SensaGroup/MotorDriver/Hardware/Docs/Output/MotorDriver.pdf

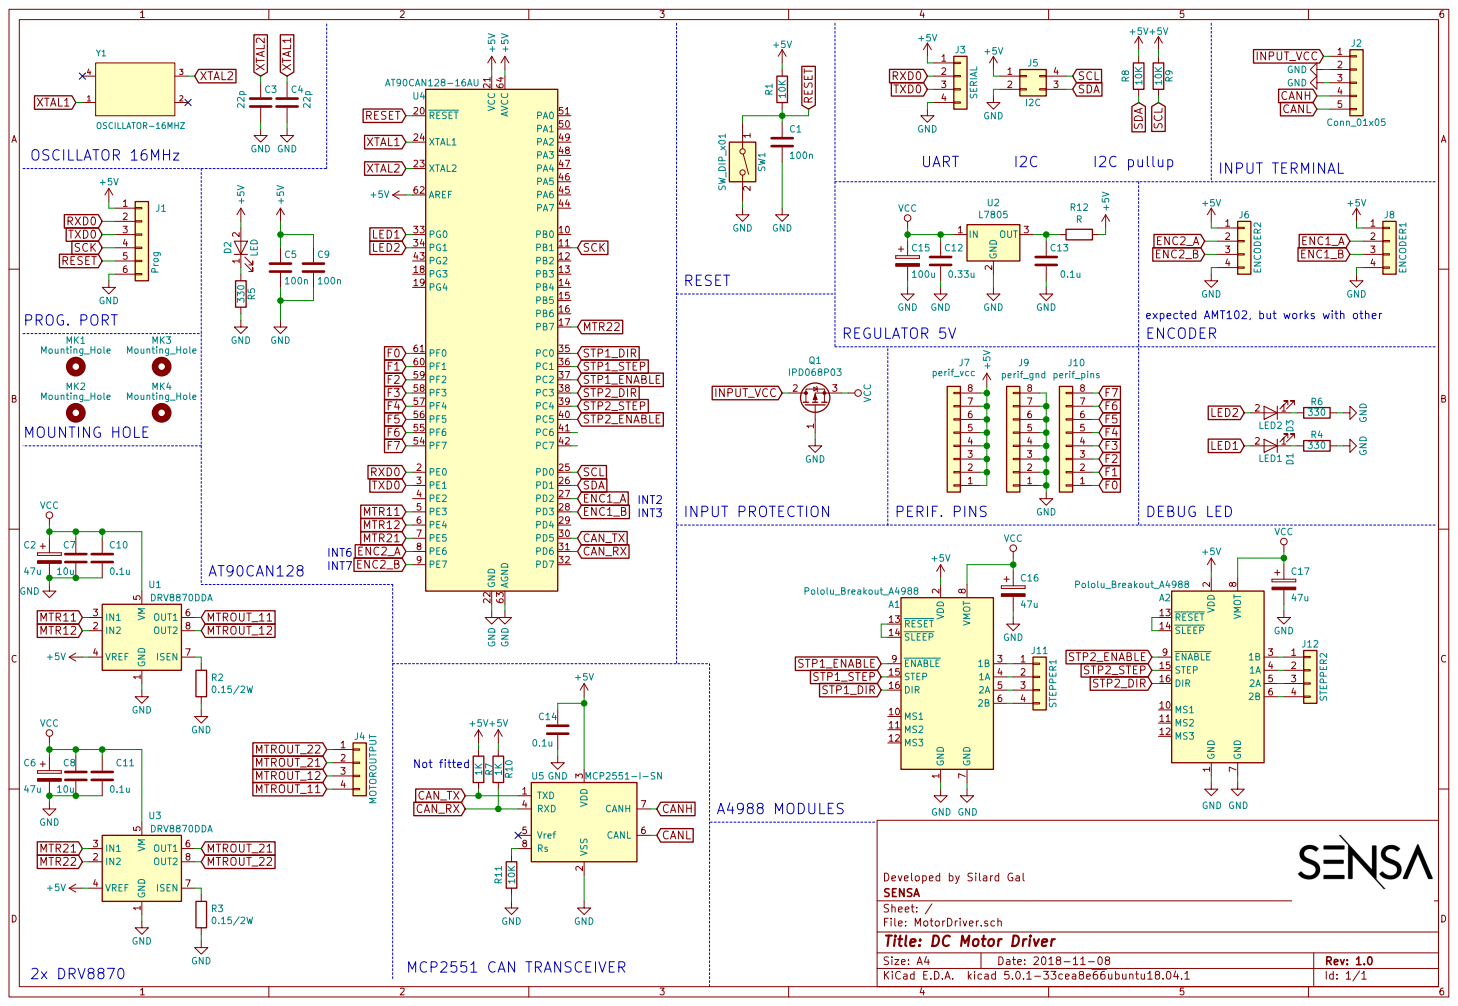
[picture p2: page 1]

1 2 D2 LED 330 R5 GND+5V MK1 Mounting_Hole MK3 Mounting_Hole MK2 Mounting_Hole MK4 Mounting_Hole GND GND CANL

expected AMT102, but works with other

1 MS1 10 MS2 11 MS3 12 RESET 13 SLEEP 14 STEP 15 DIR 16 VDD

3 RXD 4 Vref 5 CANL 6 CANH 7 Rs 8 R10 U5 MCP2551-I-SN 1KR7 1KNot fitted

Developed by Silard Gal
Id: 1/1 Title: DC Motor Driver File: MotorDriver.sch Sheet: / SENSA
