SensaGroup/MotorDriver/Hardware/MotorDriver.kicad_pcb

## KiCad design Hardware/MotorDriver.kicad_pcb (2018-11-23)

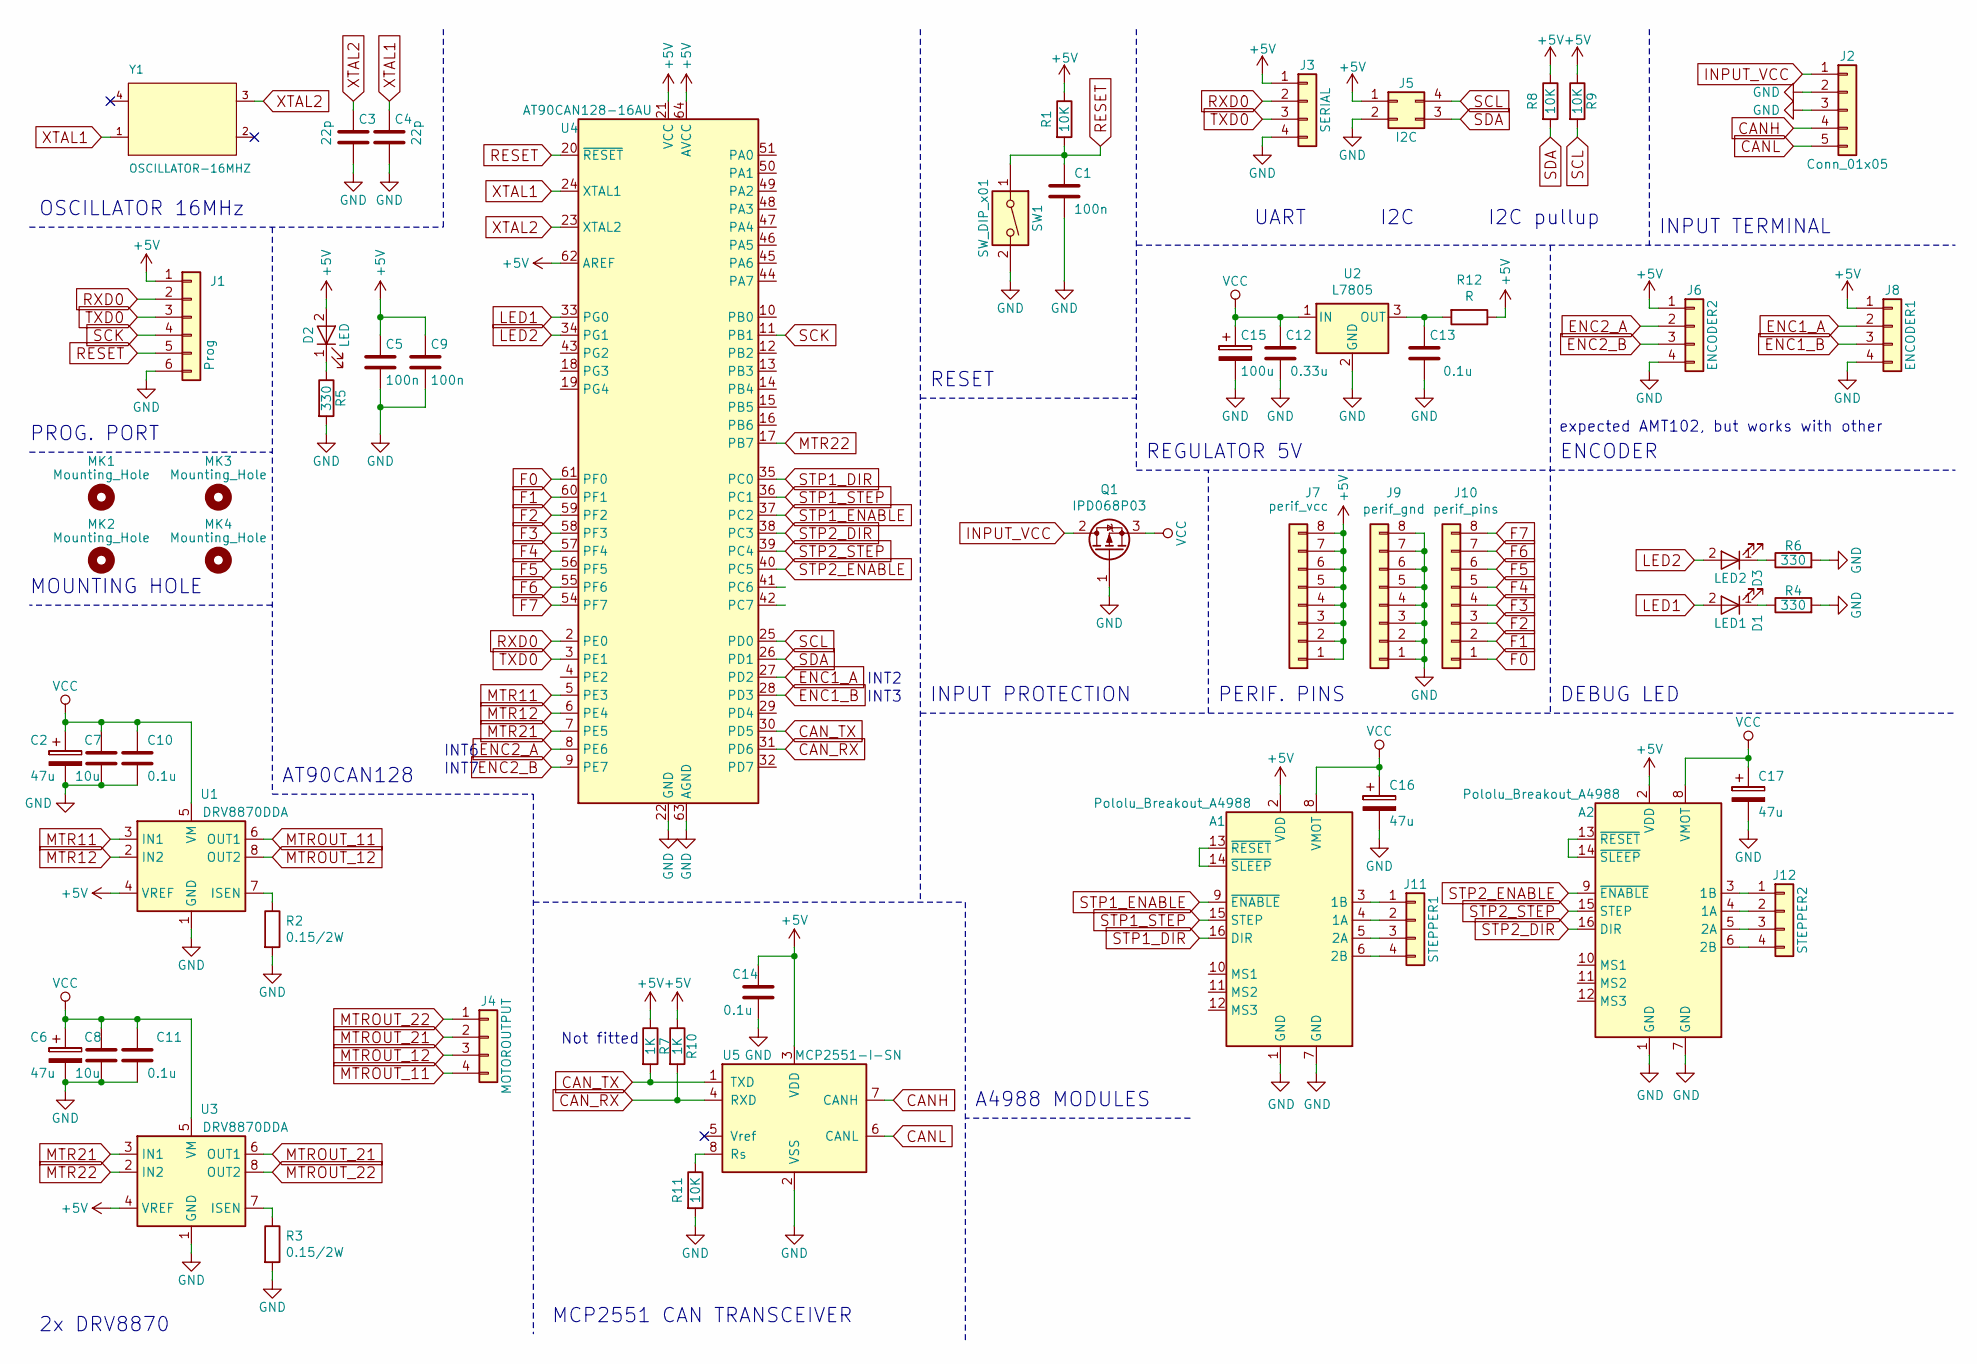
[picture p3: schematic MotorDriver.sch, DC Motor Driver]

Parts:
A1, A2: Pololu_Breakout_A4988; Pololu_Breakout-16_15.2x20.3mm
C1, C5, C9: 100n; C_0603_1608Metric
C2, C6, C16, C17: 47u; CP_Elec_6.3x5.4
C3, C4: 22p; C_0603_1608Metric
C7, C8: 10u; C_0805_2012Metric
C10, C11, C13, C14: 0.1u; C_0603_1608Metric
C12: 0.33u; C_0603_1608Metric
C15: 100u; CP_Elec_3x5.3
D1: LED1; LED_0603_1608Metric
D2: LED; LED_0603_1608Metric
D3: LED2; LED_0603_1608Metric
J1: Prog; PinHeader_1x06_P2.00mm_Vertical
J2: Conn_01x05; TerminalBlock_Phoenix_MPT-2.54mm_5pol
J3: SERIAL; Pin_Header_Straight_1x04_Pitch2.00mm
J4: MOTOROUTPUT; TerminalBlock_Phoenix_MKDS-3-4-5.08_1x04_P5.08mm_Horizontal
J5: I2C; Pin_Header_Straight_1x04_Pitch2.00mm
J6: ENCODER2; PinHeader_1x04_P2.54mm_Vertical
J7: perif_vcc; PinHeader_1x08_P2.54mm_Vertical
J8: ENCODER1; PinHeader_1x04_P2.54mm_Vertical
J9: perif_gnd; PinHeader_1x08_P2.54mm_Vertical
J10: perif_pins; PinHeader_1x08_P2.54mm_Vertical
J11: STEPPER1; TerminalBlock_TE_282834-4_1x04_P2.54mm_Horizontal
J12: STEPPER2; TerminalBlock_TE_282834-4_1x04_P2.54mm_Horizontal
MK1, MK2, MK3, MK4: Mounting_Hole; MountingHole_3.2mm_M3_DIN965_Pad
Q1: IPD068P03; TO-252-2
R1, R8, R9, R11: 10K; R_0603_1608Metric
R2, R3: 0.15/2W; R_2512_6332Metric
R4, R5, R6: 330; R_0603_1608Metric
R7, R10: 1K; R_0603_1608Metric
R12: R; R_0402_1005Metric
SW1: SW_DIP_x01; PinHeader_1x02_P1.00mm_Vertical
U1, U3: DRV8870DDA; Texas_HTSOP-8-1EP_3.9x4.9mm_P1.27mm_EP2.95x4.9mm_Mask2.4x3.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
U2: L7805; TO-252-2
U4: AT90CAN128-16AU; TQFP-64_14x14mm_P0.8mm
U5: MCP2551-I-SN; SOIC-8_3.9x4.9mm_P1.27mm
Y1: OSCILLATOR-16MHZ; Oscillator_SMD_Abracon_ASE-4pin_3.2x2.5mm

Connections:
+5V: A1.2 (VDD), A2.2 (VDD), C5.1, C9.1, C14.1, D2.2 (A), J1.1, J3.1, J5.1, J6.1, J7.1, J7.2, J7.3, J7.4, J7.5, J7.6, J7.7, J7.8, J8.1, R1.1, R7.1, R8.1, R9.1, R10.1, R12.1, U1.4 (VREF), U3.4 (VREF), U4.21 (VCC), U4.52 (VCC), U4.62 (AREF), U4.64 (AVCC), U5.3 (VDD)
CANH: J2.4, U5.7 (CANH)
CANL: J2.5, U5.6 (CANL)
CAN_RX: R10.2, U4.31 (PD6), U5.4 (RXD)
CAN_TX: R7.2, U4.30 (PD5), U5.1 (TXD)
ENC1_A: J8.2, U4.27 (PD2)
ENC1_B: J8.3, U4.28 (PD3)
ENC2_A: J6.2, U4.8 (PE6)
ENC2_B: J6.3, U4.9 (PE7)
F0: J10.1, U4.61 (PF0)
F1: J10.2, U4.60 (PF1)
F2: J10.3, U4.59 (PF2)
F3: J10.4, U4.58 (PF3)
F4: J10.5, U4.57 (PF4)
F5: J10.6, U4.56 (PF5)
F6: J10.7, U4.55 (PF6)
F7: J10.8, U4.54 (PF7)
GND: A1.1 (GND), A1.7 (GND), A2.1 (GND), A2.7 (GND), C1.2, C2.2, C3.2, C4.2, C5.2, C6.2, C7.2, C8.2, C9.2, C10.2, C11.2, C12.2, C13.2, C14.2, C15.2, C16.2, C17.2, J1.6, J2.2, J2.3, J3.4, J5.2, J6.4, J8.4, J9.1, J9.2, J9.3, J9.4, J9.5, J9.6, J9.7, J9.8, Q1.1 (G), R2.2, R3.2, R4.2, R5.2, R6.2, R11.2, SW1.2, U1.1 (GND), U1.9 (GND), U2.2 (GND), U3.1 (GND), U3.9 (GND), U4.22 (GND), U4.53 (GND), U4.63 (AGND), U5.2 (VSS)
INPUT_VCC: J2.1, Q1.2 (D)
LED1: D1.2 (A), U4.33 (PG0)
LED2: D3.2 (A), U4.34 (PG1)
MTR11: U1.3 (IN1), U4.5 (PE3)
MTR12: U1.2 (IN2), U4.6 (PE4)
MTR21: U3.3 (IN1), U4.7 (PE5)
MTR22: U3.2 (IN2), U4.17 (PB7)
MTROUT_11: J4.4, U1.6 (OUT1)
MTROUT_12: J4.3, U1.8 (OUT2)
MTROUT_21: J4.2, U3.6 (OUT1)
MTROUT_22: J4.1, U3.8 (OUT2)
unnamed: A1.3 (1B), J11.1
unnamed: A1.4 (1A), J11.2
unnamed: A1.5 (2A), J11.3
unnamed: A1.6 (2B), J11.4
unnamed: A1.13 (~RESET), A1.14 (~SLEEP)
unnamed: A2.3 (1B), J12.1
unnamed: A2.4 (1A), J12.2
unnamed: A2.5 (2A), J12.3
unnamed: A2.6 (2B), J12.4
unnamed: A2.13 (~RESET), A2.14 (~SLEEP)
unnamed: C13.1, R12.2, U2.3 (OUT)
unnamed: D1.1 (K), R4.1
unnamed: D2.1 (K), R5.1
unnamed: D3.1 (K), R6.1
unnamed: R2.1, U1.7 (ISEN)
unnamed: R3.1, U3.7 (ISEN)
unnamed: R11.1, U5.8 (Rs)
RESET: C1.1, J1.5, R1.2, SW1.1, U4.20 (~RESET)
RXD0: J1.2, J3.2, U4.2 (PE0)
SCK: J1.4, U4.11 (PB1)
SCL: J5.4, R9.2, U4.25 (PD0)
SDA: J5.3, R8.2, U4.26 (PD1)
STP1_DIR: A1.16 (DIR), U4.35 (PC0)
STP1_ENABLE: A1.9 (~ENABLE), U4.37 (PC2)
STP1_STEP: A1.15 (STEP), U4.36 (PC1)
STP2_DIR: A2.16 (DIR), U4.38 (PC3)
STP2_ENABLE: A2.9 (~ENABLE), U4.40 (PC5)
STP2_STEP: A2.15 (STEP), U4.39 (PC4)
TXD0: J1.3, J3.3, U4.3 (PE1)
VCC: A1.8 (VMOT), A2.8 (VMOT), C2.1, C6.1, C7.1, C8.1, C10.1, C11.1, C12.1, C15.1, C16.1, C17.1, Q1.3 (S), U1.5 (VM), U2.1 (IN), U3.5 (VM)
XTAL1: C4.1, U4.24 (XTAL1), Y1.1 (EN)
XTAL2: C3.1, U4.23 (XTAL2), Y1.3 (OUT)

Notes on the sheet:
OSCILLATOR 16MHz
UART
I2C
I2C pullup
RESET
INT2
INT3
INT6
INT7
expected AMT102, but works with other
Not fitted
INPUT TERMINAL
ENCODER
REGULATOR 5V
INPUT PROTECTION
PERIF. PINS
DEBUG LED
MCP2551 CAN TRANSCEIVER
2x DRV8870
PROG. PORT
MOUNTING HOLE
AT90CAN128
A4988 MODULES

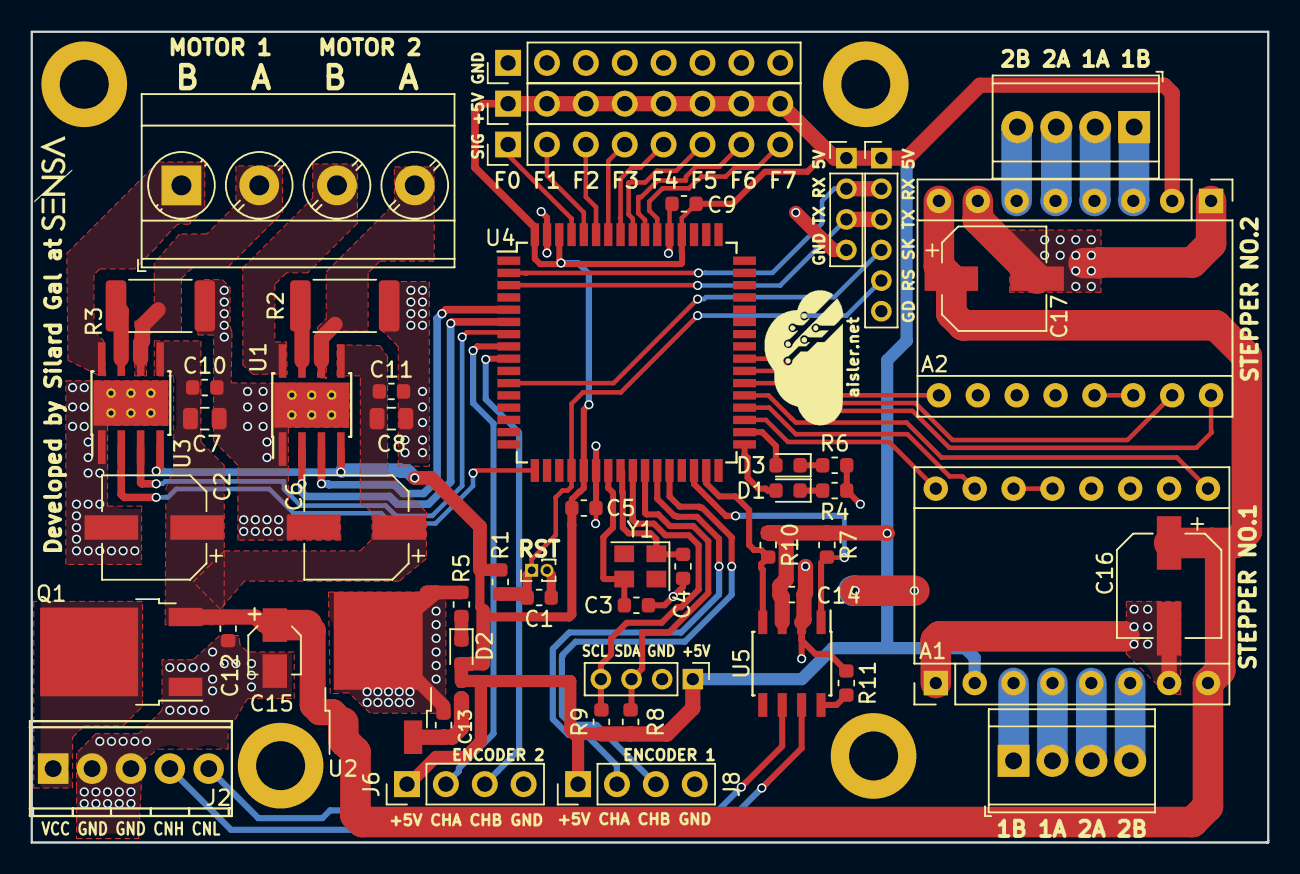
[picture p4: board MotorDriver.kicad_pcb from above]

Board: 2 copper layers, 80.8 x 53.0 mm, 58 parts (0 on the bottom side), 61 nets.
