SensaGroup/MotorDriver/(commit log)

2018-11-23 Main files
    [MotorDriver-2018-10-15-23-12-19.sch, MotorDriver.kicad_pcb, MotorDriver.sch, MotorDriver.xml]
2018-12-19 LED, UART, Switches and DC working. Stepper needs testing and CAN Bus
2019-03-18 CAN Bus working with 100kbps
2019-03-22 Steppers should work fine now
2019-03-26 Readme and pictures
    [MotorDriver.sch]
